JQIamo/teach-me-a-pid/kicad/basic_pid/basic_pid.kicad_pcb

## KiCad design kicad/basic_pid/basic_pid.kicad_pcb (2024-07-03)

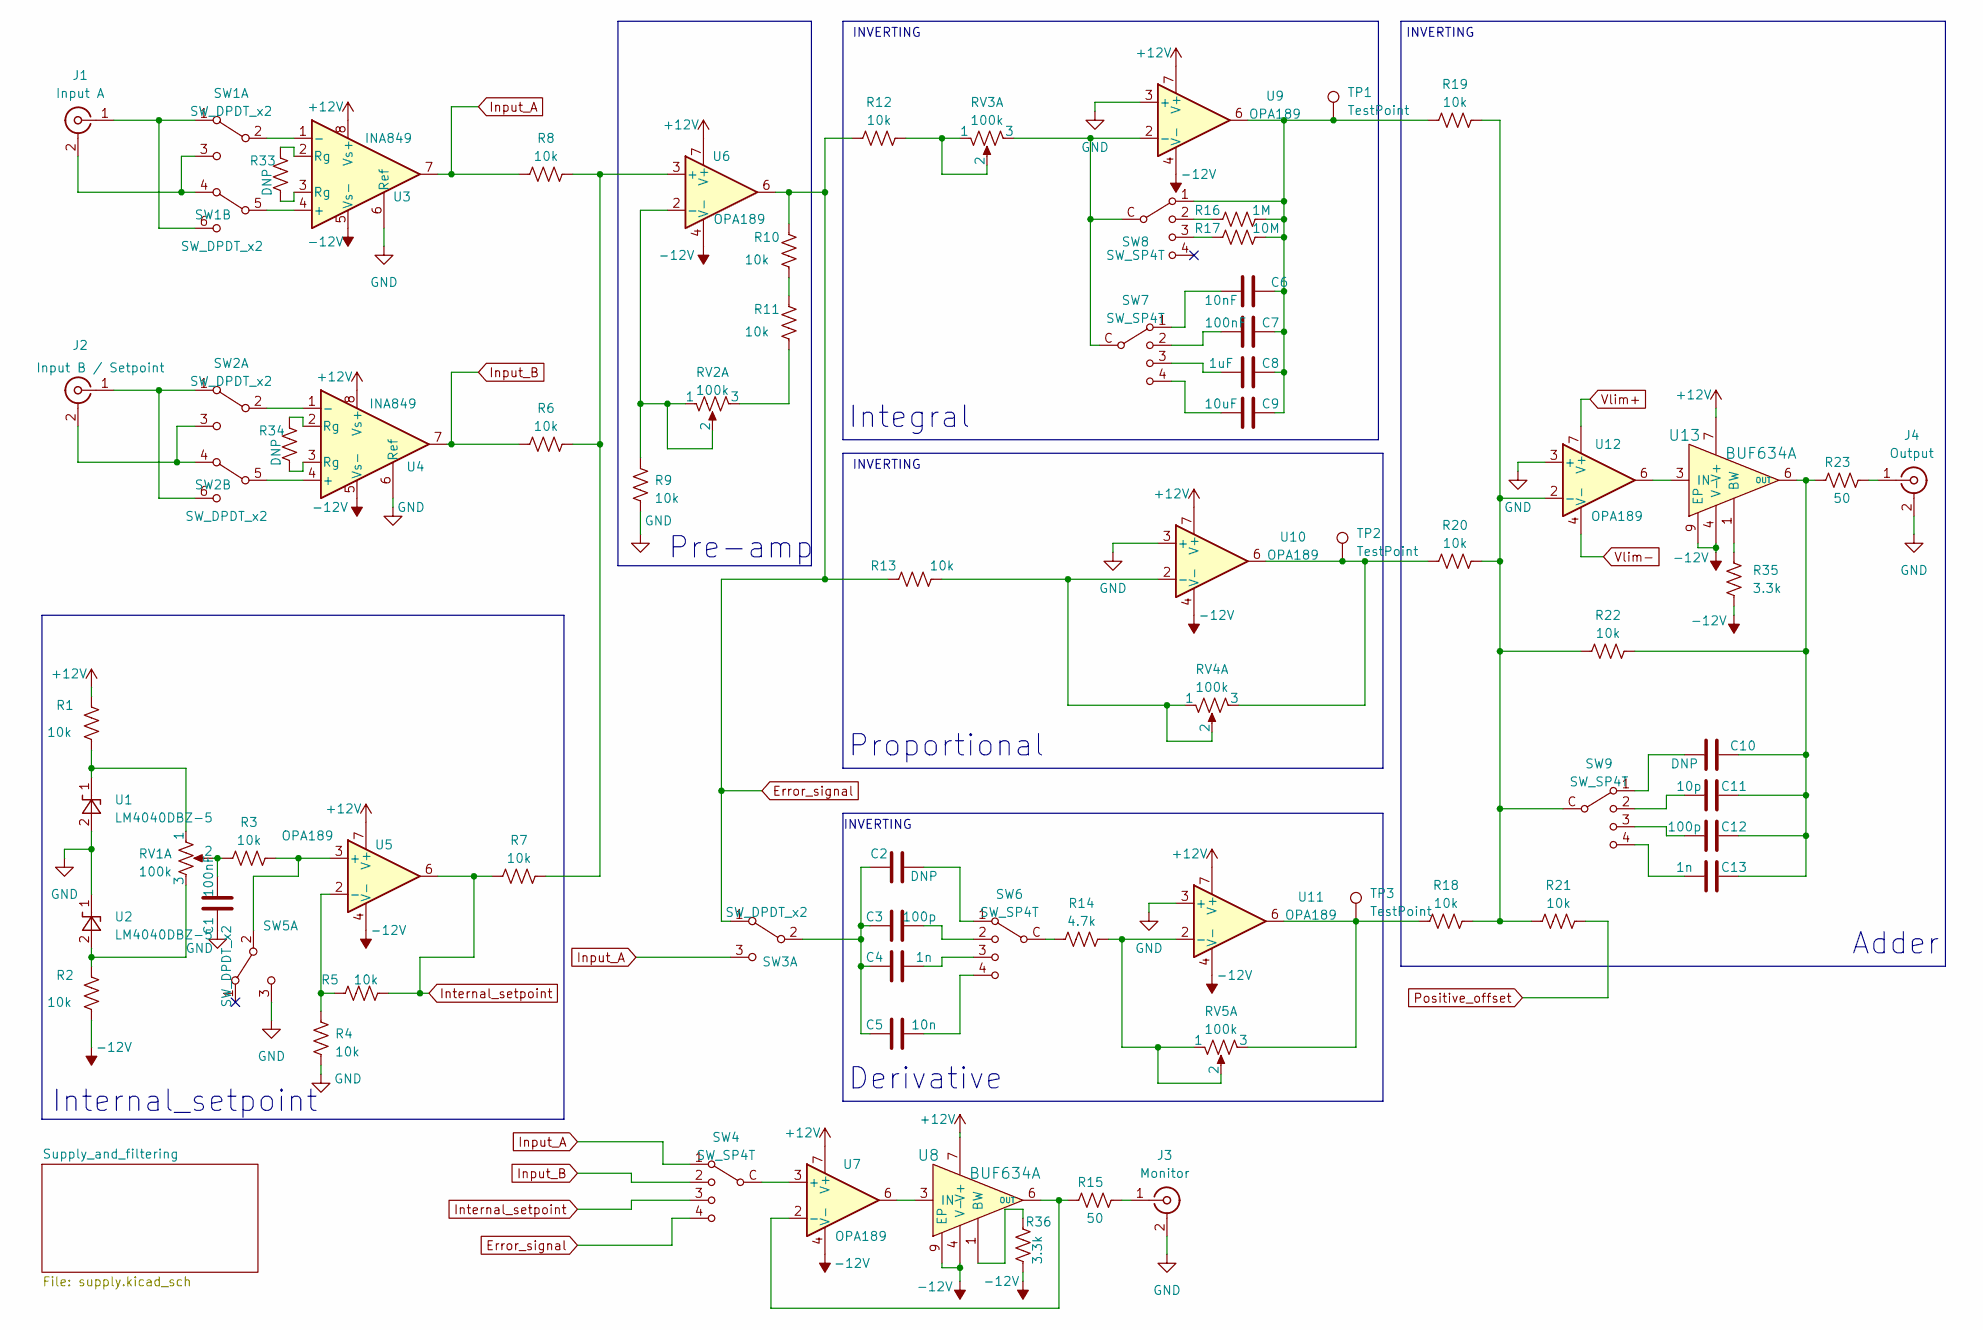
[picture p1: schematic basic_pid.kicad_sch]

Parts:
C1, C7: 100nF; C_0805_2012Metric
C2, C10: DNP; C_0805_2012Metric
C3, C12: 100p; C_0805_2012Metric
C4, C13: 1n; C_0805_2012Metric
C5: 10n; C_0805_2012Metric
C6: 10nF; C_0805_2012Metric
C8: 1uF; C_0805_2012Metric
C9: 10uF; C_0805_2012Metric
C11: 10p; C_0805_2012Metric
J1: Input A; BNC_Amphenol_031-5539_Vertical
J2: Input B / Setpoint; BNC_Amphenol_031-5539_Vertical
J3: Monitor; BNC_Amphenol_031-5539_Vertical
J4: Output; BNC_Amphenol_031-5539_Vertical
R1, R2: 10k; R_0805_2012Metric
R3, R4, R5, R6, R7, R8, R9, R10, R11, R12, R13, R18, R19, R20, R21, R22: 10k; R_0805_2012Metric; DIGIKEY 2019-RN73H2ATTD1002B25CT-ND
R14: 4.7k; R_0805_2012Metric
R15, R23: 50; R_0805_2012Metric
R16: 1M; R_0805_2012Metric; PARTNO AC0805JR-071ML; DIGIKEY YAG3766CT-ND
R17: 10M; R_0805_2012Metric; PARTNO RC0805JR-0710ML; DIGIKEY 311-10MARCT-ND
R33, R34: DNP; R_0805_2012Metric; DIGIKEY 2019-RN73H2ATTD1002B25CT-ND
R35, R36: 3.3k; R_0805_2012Metric; DIGIKEY 2019-RN73H2ATTD3301B25CT-ND
RV1, RV2, RV3, RV4, RV5: 100k; Slide_pot_45mm; PARTNO PTL45-15O0-104B1; DIGIKEY PTL45-15O0-104B1-ND
SW1, SW2, SW3, SW5: SW_DPDT_x2; MHS222; PARTNO 1825289-1; DIGIKEY 450-1572-ND
SW4, SW6, SW7, SW8, SW9: SW_SP4T; SLB1470; PARTNO SLB1470; DIGIKEY 679-2621-ND
TP1, TP2, TP3: TestPoint; TestPoint_Pad_D3.0mm
U1, U2: LM4040DBZ-5; SOT-23; PARTNO LM4040B50FTA; DIGIKEY LM4040B50FTADICT-ND
U3, U4: INA849; SOIC-8_3.9x4.9mm_P1.27mm; PARTNO INA849DR‎; DIGIKEY 296-INA849DRCT-ND‎
U5, U6, U7, U9, U10, U11, U12: OPA189; SOIC-8_3.9x4.9mm_P1.27mm; PARTNO OPA189ID; DIGIKEY 296-47522-ND
U8, U13: BUF634A; TI_SO-PowerPAD-8_ThermalVias; PARTNO BUF634AIDDAR; DIGIKEY 296-BUF634AIDDARCT-ND

Connections:
+12V: R1.2, U3.8 (Vs+), U4.8 (Vs+), U5.7 (V+), U6.7 (V+), U7.7 (V+), U8.7 (V+), U9.7 (V+), U10.7 (V+), U11.7 (V+), U13.7 (V+); also elsewhere on the board
-12V: R2.1, R35.1, R36.1, U3.5 (Vs-), U4.5 (Vs-), U5.4 (V-), U6.4 (V-), U7.4 (V-), U8.4 (V-), U8.9 (EP), U9.4 (V-), U10.4 (V-), U11.4 (V-), U13.4 (V-), U13.9 (EP); also elsewhere on the board
Error_signal: R10.2, R12.1, R13.1, SW3.1 (A), SW4.4, U6.6
GND: C1.1, J3.2 (Ext), J4.2 (Ext), R4.1, R9.1, SW5.3 (C), U1.2 (A), U2.1 (K), U3.6 (Ref), U4.6 (Ref), U9.3 (+), U10.3 (+), U11.3 (+), U12.3 (+); also elsewhere on the board
Input_A: R8.1, SW3.3 (C), SW4.1, U3.7
Input_B: R6.1, SW4.2, U4.7
Internal_setpoint: R5.2, R7.1, SW4.3, U5.6
unnamed: C1.2, R3.1, RV1.2
unnamed: C2.2, SW6.1
unnamed: C3.2, SW6.2
unnamed: C4.2, SW6.3
unnamed: C5.2, SW6.4
unnamed: C6.1, C7.1, C8.1, C9.1, R16.2, R17.2, R19.1, SW8.1, TP1.1, U9.6
unnamed: C6.2, SW7.1
unnamed: C7.2, SW7.2
unnamed: C8.2, SW7.3
unnamed: C9.2, SW7.4
unnamed: C10.2, SW9.1
unnamed: C11.2, SW9.2
unnamed: C12.2, SW9.3
unnamed: C13.2, SW9.4
unnamed: J1.2 (Ext), SW1.3 (C), SW1.4 (A)
unnamed: J1.1 (In), SW1.1 (A), SW1.6 (C)
unnamed: J2.2 (Ext), SW2.3 (C), SW2.4 (A)
unnamed: J2.1 (In), SW2.1 (A), SW2.6 (C)
unnamed: J3.1 (In), R15.2
unnamed: J4.1 (In), R23.2
unnamed: R10.1, R11.2
unnamed: R11.1, RV2.3
unnamed: R12.2, RV3.1, RV3.2
unnamed: R16.1, SW8.2
unnamed: R17.1, SW8.3
unnamed: R18.1, RV5.3, TP3.1, U11.6
unnamed: R20.1, RV4.3, TP2.1, U10.6
unnamed: R33.1, U3.3 (Rg)
unnamed: R33.2, U3.2 (Rg)
unnamed: R34.1, U4.3 (Rg)
unnamed: R34.2, U4.2 (Rg)
unnamed: SW1.2 (B), U3.1 (-)
unnamed: SW1.5 (B), U3.4 (+)
unnamed: SW2.2 (B), U4.1 (-)
unnamed: SW2.5 (B), U4.4 (+)
unnamed: C2.1, C3.1, C4.1, C5.1, SW3.2 (B)
unnamed: SW4.C (Common), U7.3 (+)
unnamed: R3.2, SW5.2 (B), U5.3 (+)
unnamed: R14.1, SW6.C (Common)
unnamed: RV3.3, SW7.C (Common), SW8.C (Common), U9.2 (-)
unnamed: R18.2, R19.2, R20.2, R21.1, R22.1, SW9.C (Common), U12.2 (-)
unnamed: R1.1, RV1.1, U1.1 (K)
unnamed: R2.2, RV1.3, U2.2 (A)
unnamed: R4.2, R5.1, U5.2 (-)
unnamed: R6.2, R7.2, R8.2, U6.3 (+)
unnamed: R9.2, RV2.1, RV2.2, U6.2 (-)
unnamed: R15.1, U7.2 (-), U8.6 (OUT)
unnamed: R36.2, U8.1 (BW)
unnamed: U7.6, U8.3 (IN)
unnamed: R13.2, RV4.1, RV4.2, U10.2 (-)
unnamed: R14.2, RV5.1, RV5.2, U11.2 (-)
unnamed: R35.2, U13.1 (BW)
unnamed: U12.6, U13.3 (IN)
unnamed: C10.1, C11.1, C12.1, C13.1, R22.2, R23.1, U13.6 (OUT)
Positive_offset: R21.2; also elsewhere on the board
Vlim+: U12.7 (V+); also elsewhere on the board
Vlim-: U12.4 (V-); also elsewhere on the board

Notes on the sheet:
INVERTING
Pre-amp
Proportional
Adder
Derivative
Integral
Internal_setpoint

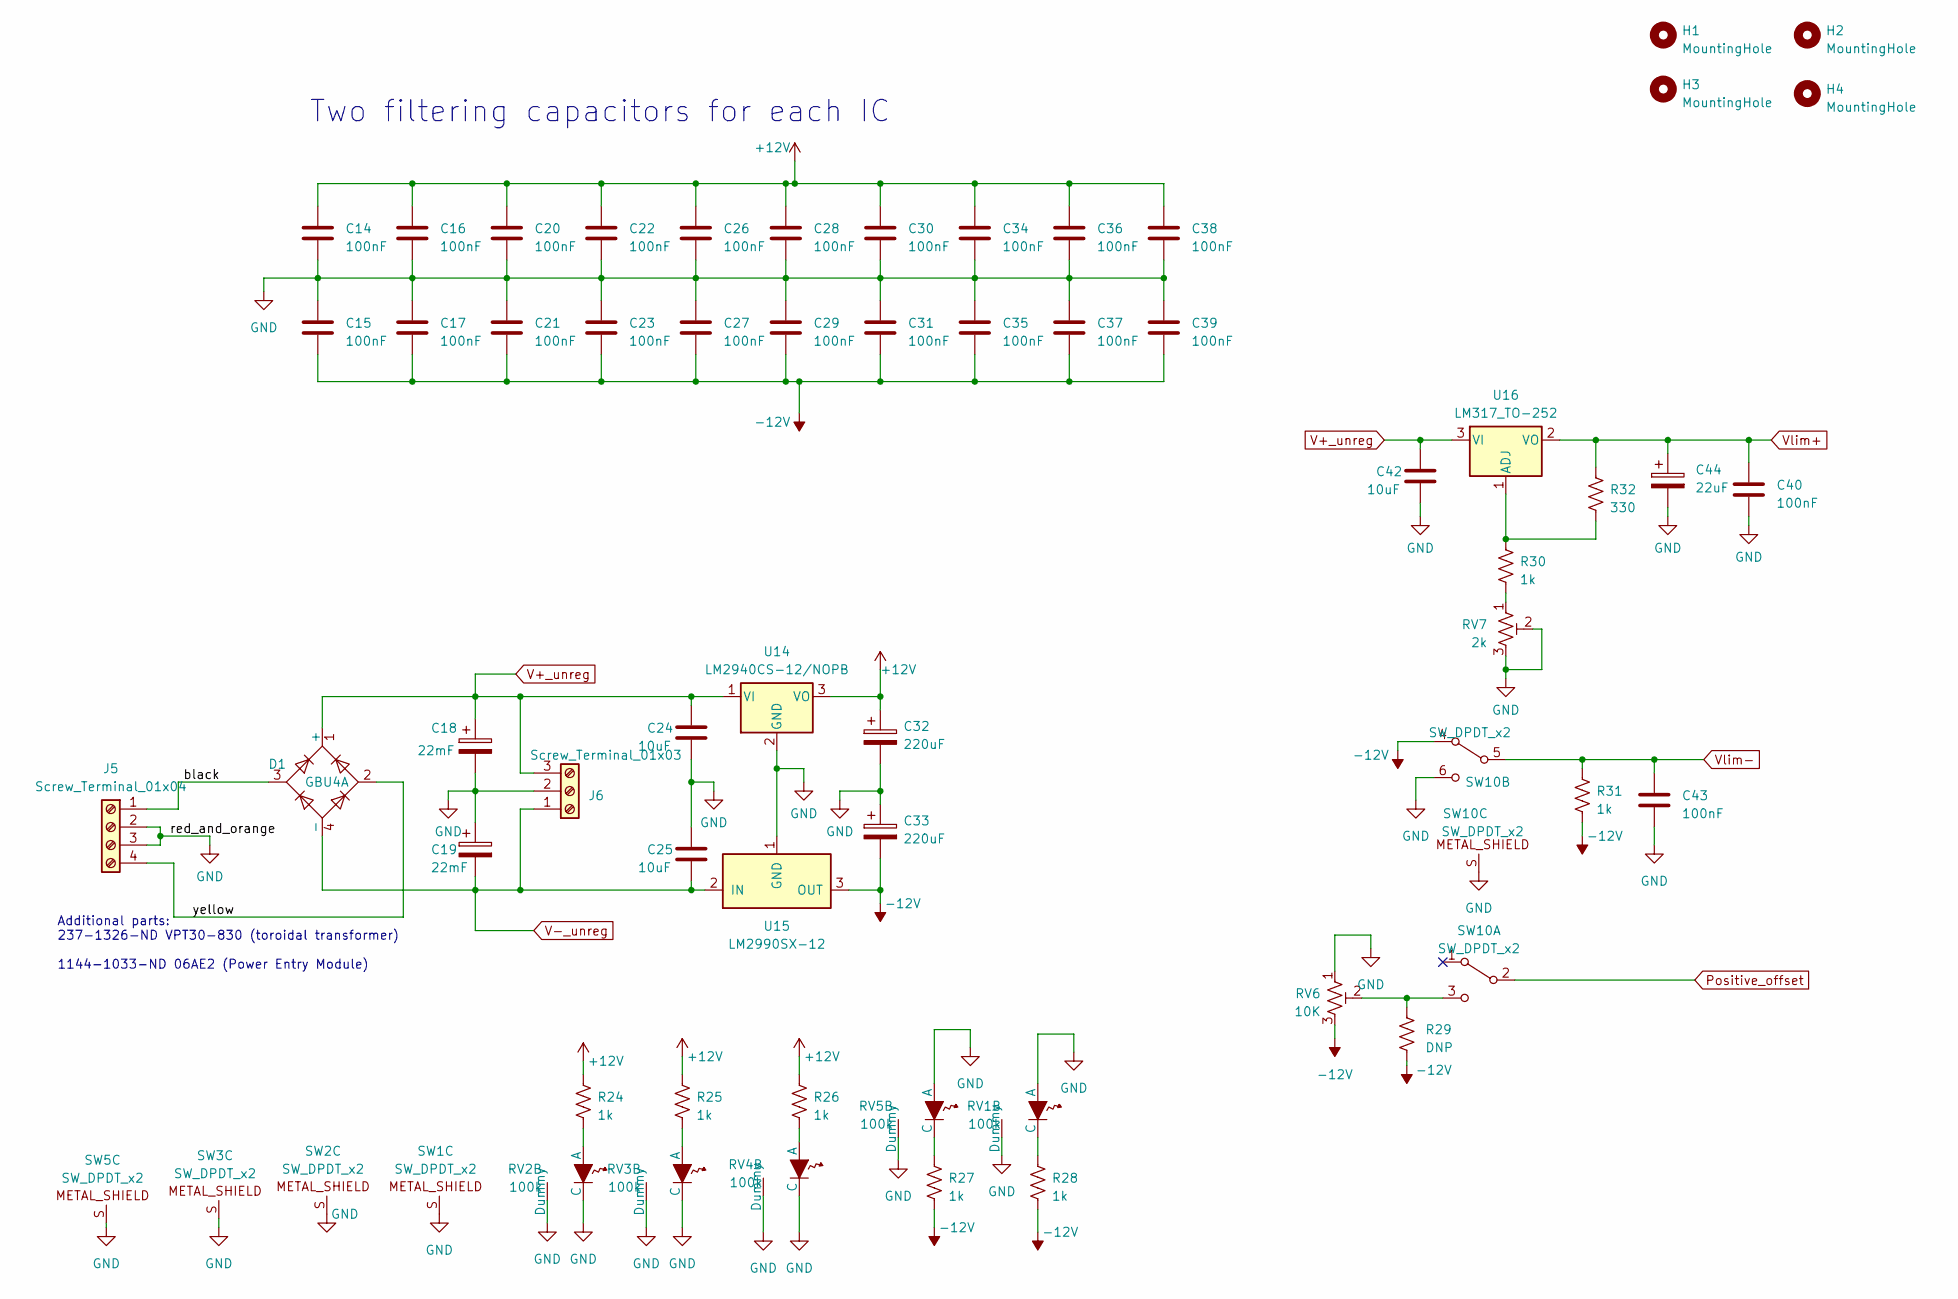
[picture p2: schematic supply.kicad_sch]

Parts:
C14, C15, C16, C17, C20, C21, C22, C23, C26, C27, C28, C29, C30, C31, C34, C35, C36, C37, C38, C39, C40, C43: 100nF; C_0805_2012Metric
C18, C19: 22mF; CP_Radial_D30.0mm_P10.00mm_SnapIn; PARTNO 380LX223M035K052; DIGIKEY 338-2433-ND
C24, C25, C42: 10uF; C_1210_3225Metric
C32, C33: 220uF; CP_Elec_8x6.9; PARTNO EEE-1VA221UP; DIGIKEY PCE3955CT-ND
C44: 22uF; CP_Elec_4x5.8; PARTNO UCM1V220MCL1GS; DIGIKEY 493-14929-1-ND
D1: GBU4A; Diode_Bridge_Vishay_GBU; PARTNO GBU4A; DIGIKEY GBU4A-ND
H1, H2, H3, H4: MountingHole; MountingHole_3.2mm_M3_ISO14580
J5: Screw_Terminal_01x04; TerminalBlock_Altech_AK300-4_P5.00mm
J6: Screw_Terminal_01x03; TerminalBlock_Altech_AK300-3_P5.00mm
R24, R25, R26, R27, R28, R30, R31: 1k; R_0805_2012Metric
R29: DNP; R_0805_2012Metric
R32: 330; R_0805_2012Metric
RV1, RV2, RV3, RV4, RV5: 100k; Slide_pot_45mm; PARTNO PTL45-15O0-104B1; DIGIKEY PTL45-15O0-104B1-ND
RV6: 10K; Potentiometer_Bourns_3296W_Vertical; PARTNO 3296W-1-103RLF; DIGIKEY 118-3296W-1-103RLFCT-ND
RV7: 2k; Potentiometer_Bourns_3296W_Vertical; PARTNO M64W202KB40; DIGIKEY SP064W-2.0K-ND
SW1, SW2, SW3, SW5, SW10: SW_DPDT_x2; MHS222; PARTNO 1825289-1; DIGIKEY 450-1572-ND
U14: LM2940CS-12/NOPB; TO-263-3_TabPin2; PARTNO LM2940CS-12/NOPB; DIGIKEY LM2940CS-12/NOPB-ND
U15: LM2990SX-12; TO-263-3_TabPin2; PARTNO LM2990SX-12/NOPB; DIGIKEY LM2990SX-12/NOPBCT-ND
U16: LM317_TO-252; TO-252-2; PARTNO LM317MDT-TR; DIGIKEY 497-1574-1-ND

Connections:
+12V: C14.1, C16.1, C20.1, C22.1, C26.1, C28.1, C30.1, C32.1, C34.1, C36.1, C38.1, R24.2, R25.2, R26.2, U14.3 (VO); also elsewhere on the board
-12V: C15.2, C17.2, C21.2, C23.2, C27.2, C29.2, C31.2, C33.2, C35.2, C37.2, C39.2, R27.1, R28.1, R29.1, R31.1, RV6.3, SW10.4 (A), U15.3 (OUT); also elsewhere on the board
/Supply_and_filtering/black: D1.3, J5.1
/Supply_and_filtering/yellow: D1.2, J5.4
GND: C14.2, C15.1, C16.2, C17.1, C18.2, C19.1, C20.2, C21.1, C22.2, C23.1, C24.2, C25.1, C26.2, C27.1, C28.2, C29.1, C30.2, C31.1, C32.2, C33.1, C34.2, C35.1, C36.2, C37.1, C38.2, C39.1, C40.2, C42.2, C43.2, C44.2, J5.2, J5.3, J6.2, RV1.A, RV1.L (Dummy), RV2.C, RV2.L (Dummy), RV3.C, RV3.L (Dummy), RV4.C, RV4.L (Dummy), RV5.A, RV5.L (Dummy), RV6.1, RV7.2, RV7.3, SW1.S, SW2.S, SW3.S, SW5.S, SW10.6 (C), SW10.S, U14.2 (GND), U15.1 (GND); also elsewhere on the board
unnamed: R24.1, RV2.A
unnamed: R25.1, RV3.A
unnamed: R26.1, RV4.A
unnamed: R27.2, RV5.C
unnamed: R28.2, RV1.C
unnamed: R30.1, RV7.1
unnamed: R29.2, RV6.2, SW10.3 (C)
unnamed: R30.2, R32.1, U16.1 (ADJ)
Positive_offset: SW10.2 (B); also elsewhere on the board
V+_unreg: C18.1, C24.1, C42.1, D1.1 (+), J6.3, U14.1 (VI), U16.3 (VI)
V-_unreg: C19.2, C25.2, D1.4 (-), J6.1, U15.2 (IN)
Vlim+: C40.1, C44.1, R32.2, U16.2 (VO); also elsewhere on the board
Vlim-: C43.1, R31.2, SW10.5 (B); also elsewhere on the board

Notes on the sheet:
Two filtering capacitors for each IC
Additional parts: 237-1326-ND VPT30-830 (toroidal transformer) 1144-1033-ND 06AE2 (Power Entry Module)

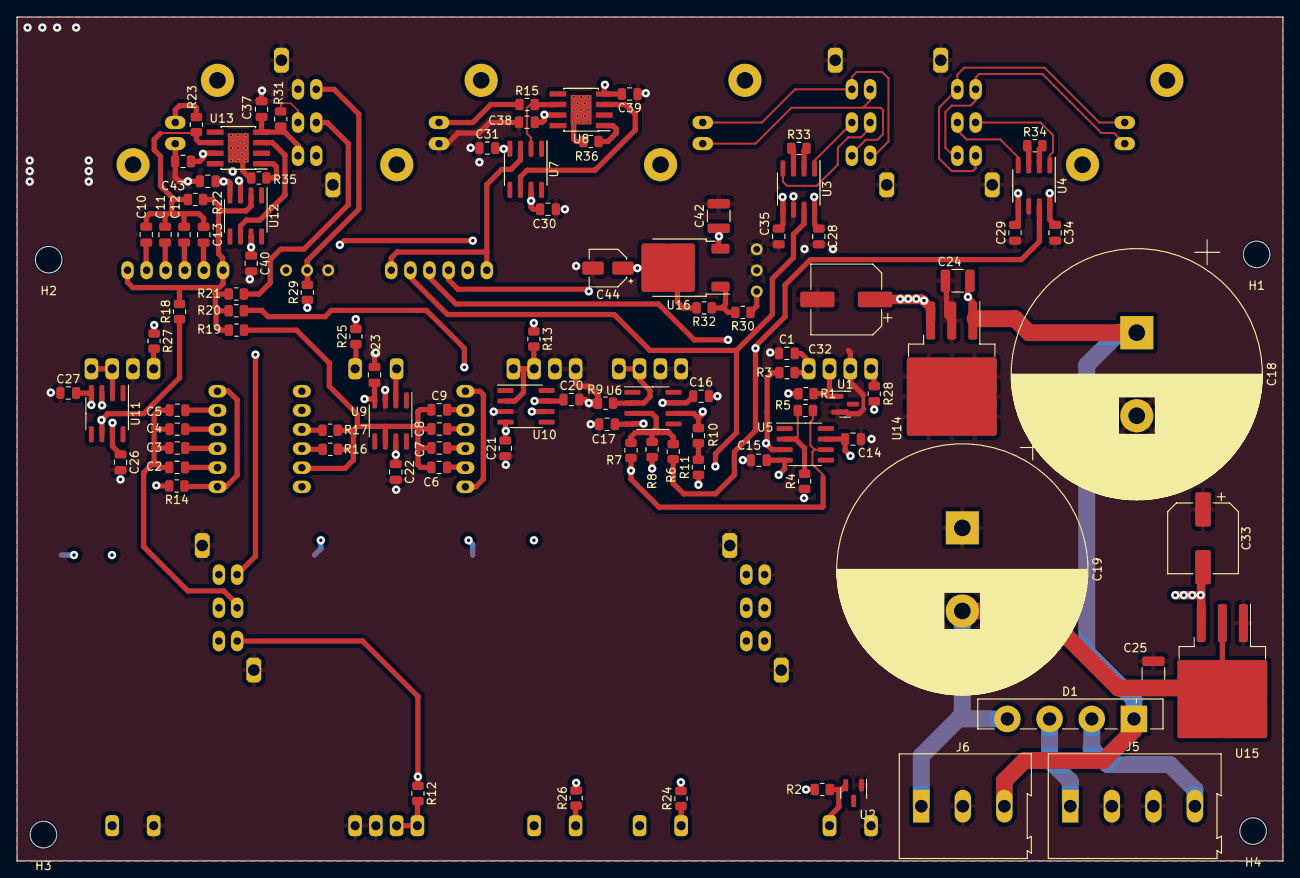
[picture p3: board basic_pid.kicad_pcb from above]

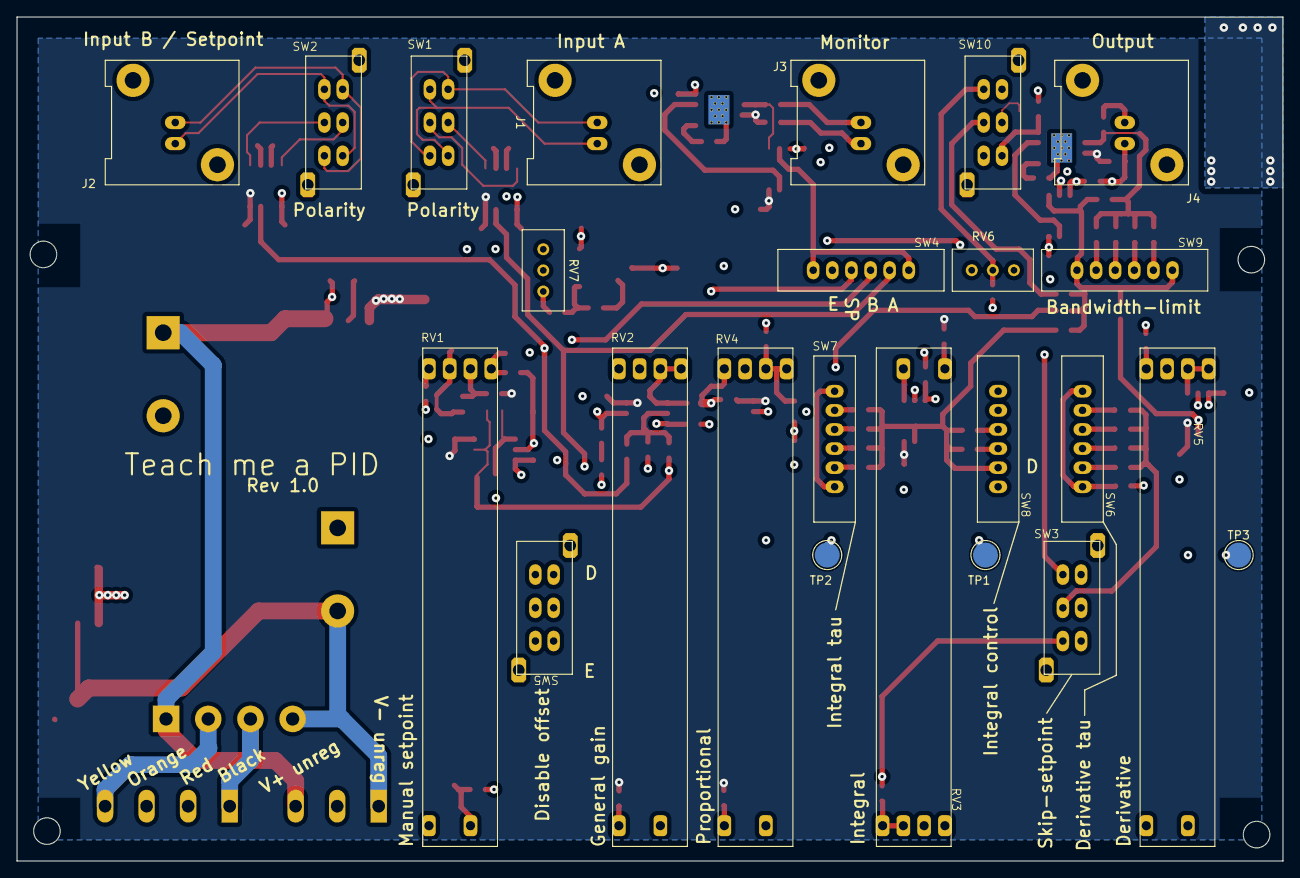
[picture p4: board basic_pid.kicad_pcb from below]

Board: 4 copper layers, 152.4 x 101.6 mm, 126 parts (24 on the bottom side), 76 nets.
