JQIamo/teach-me-a-pid/(commit log)

2023-07-06 This contains ideas for a high-speed design
    [basic_pid.kicad_sch]
2023-10-30 Fixed wrong part and added shunt resistor values
    [basic_pid.kicad_pcb, basic_pid.kicad_sch, supply.kicad_sch]
2024-07-03 Fixed monitor instability
    Added a 3.3 kOhm resistor on each output buffer's bandwith control pin
    to increase the bandwidth from 30 MHz to 90 MHz.
    This should prevent oscillations and instabilities we noticed while
    testing the PID
    [basic_pid.kicad_pcb, basic_pid.kicad_sch, supply.kicad_sch]
